noeljary/Inclinometer/board/INCLINOMETER_BOARD.png

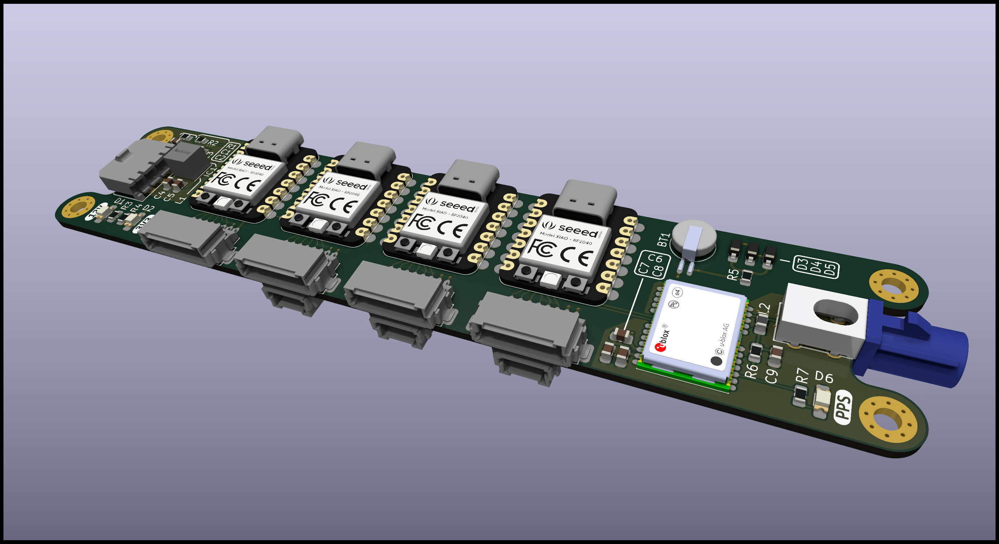
board/INCLINOMETER_BOARD.png
