noeljary/Inclinometer/board/test_bench/display_board.3mf

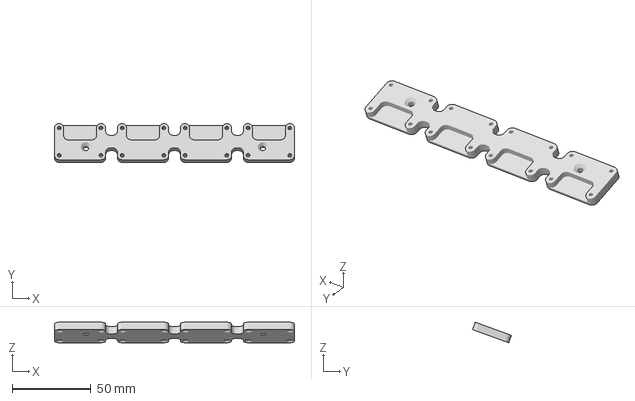
[picture p2: CAD file, 2023-11-25]
board/test_bench/display_board.3mf
152.5 x 24.7 x 13.1 mm
