noeljary/Inclinometer/board/test_bench/riser.3mf

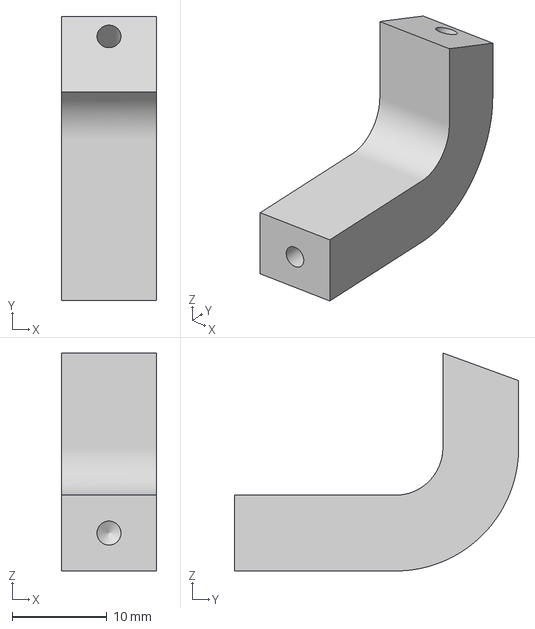
[picture p3: CAD file, 2023-11-25]
board/test_bench/riser.3mf
10.0 x 30.0 x 23.0 mm
