noeljary/Inclinometer/board/test_bench/base.3mf

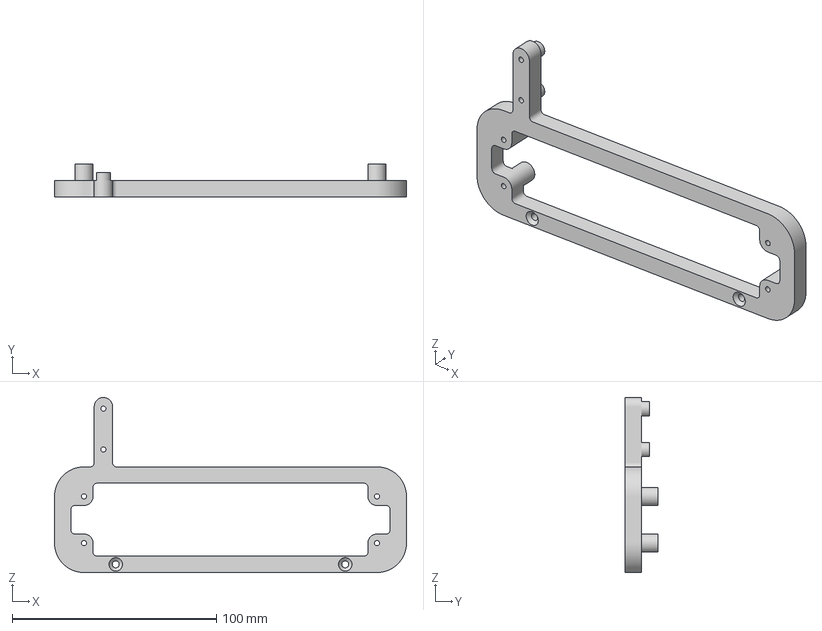
[picture p4: CAD file, 2023-11-25]
board/test_bench/base.3mf
172.4 x 16.0 x 85.8 mm
