noeljary/Inclinometer/board/INCLINOMETER_BOARD.kicad_pcb

## KiCad design board/INCLINOMETER_BOARD.kicad_pcb (2023-11-25)

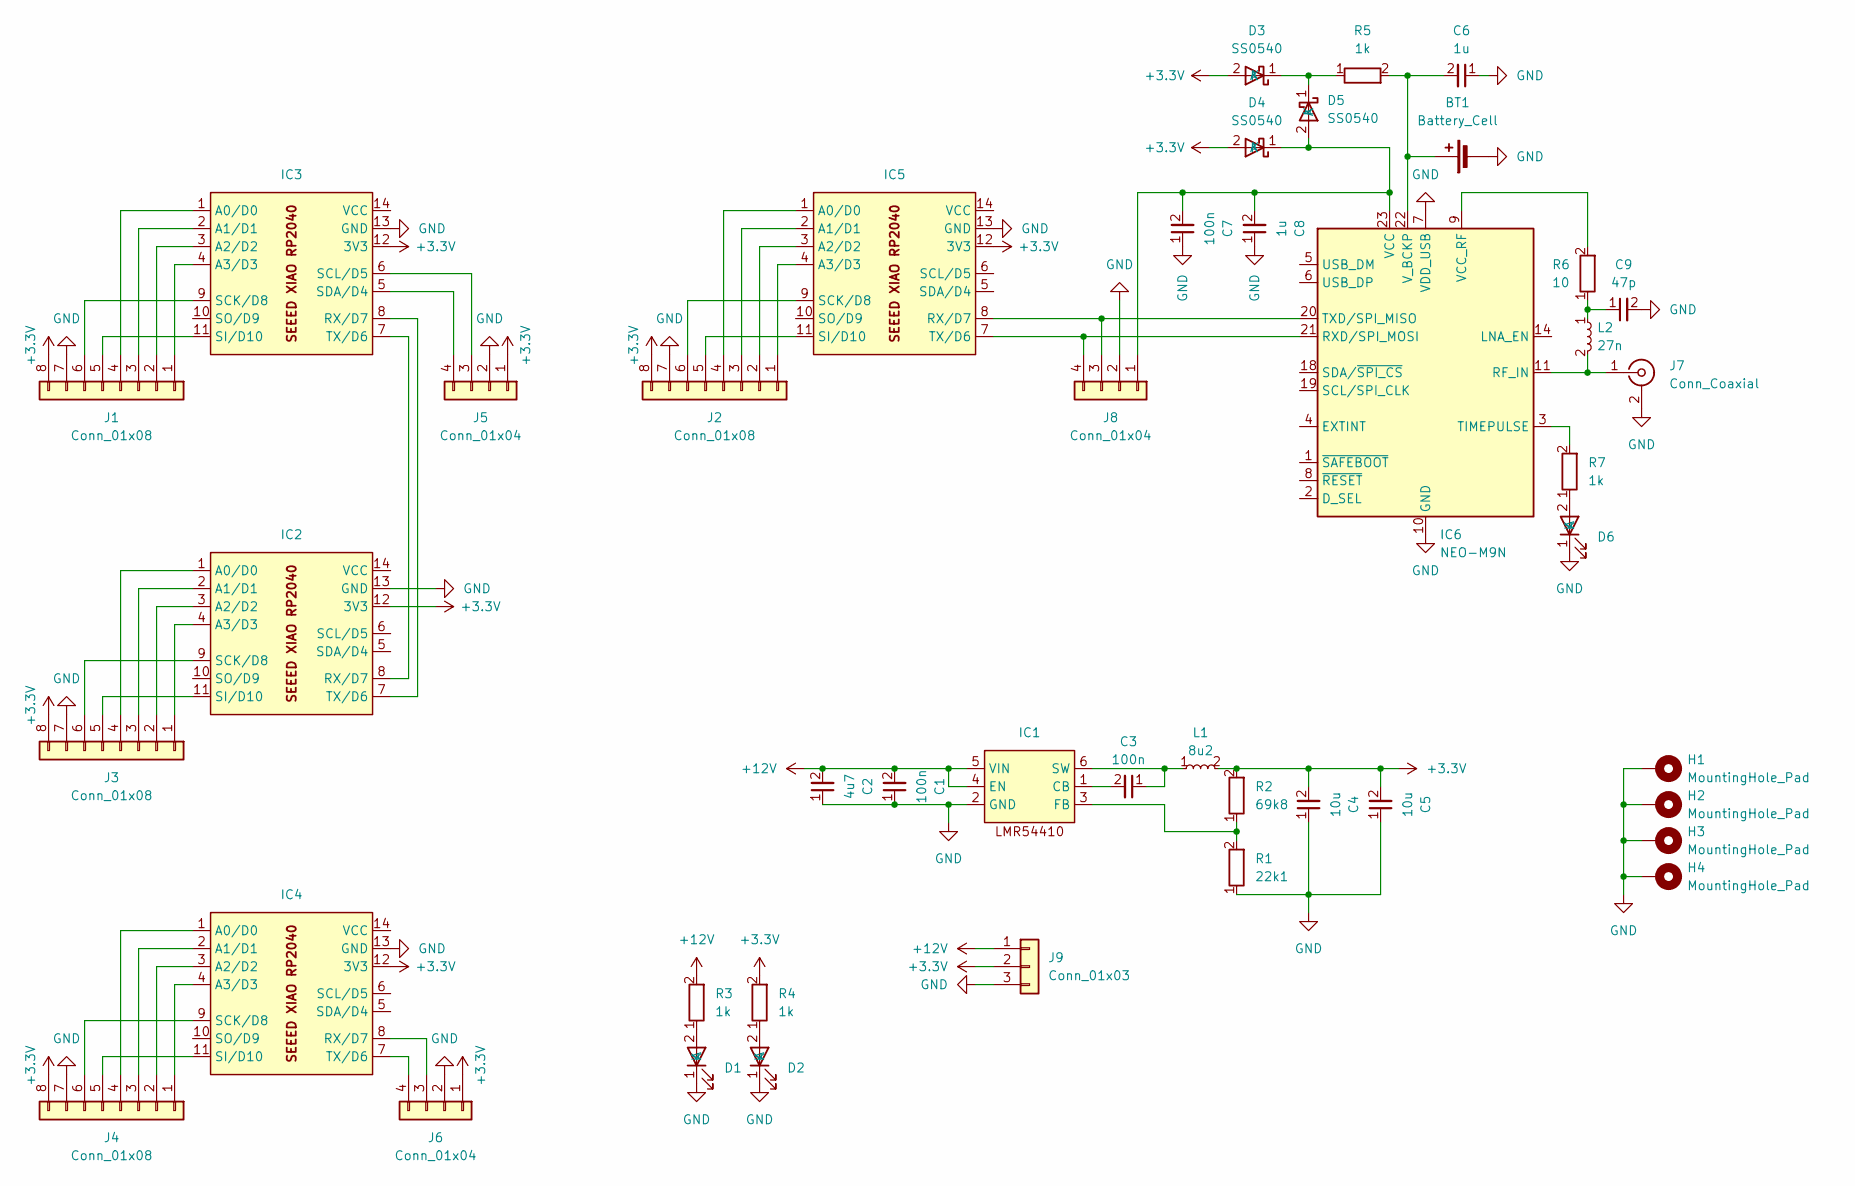
[picture p5: schematic INCLINOMETER_BOARD.kicad_sch]

Parts:
BT1: Battery_Cell; BAT-MS621
C1, C3, C7: 100n; C0805
C2: 4u7; C0805
C4, C5: 10u; C0805
C6, C8: 1u; C0805
C9: 47p; C0805
D1, D2, D6: 1206
D3, D4, D5: SS0540; SOD-123
H1, H2, H3, H4: MountingHole_Pad; MountingHole_3.2mm_M3_Pad_Via
IC1: SOT23-6
IC2, IC3, IC4, IC5: SEEED_XIAO
IC6: NEO-M9N; UBLOX-NEO-M9N
J1, J2, J3, J4: Conn_01x08; TE-292228-8
J5, J6, J8: Conn_01x04; TE-292228-4
J7: Conn_Coaxial; FAKRA_R197.160._28
J9: Conn_01x03; MICROFIT3.0-1x3-HORIZ
L1: 8u2; L6055
L2: 27n; L0805
R1: 22k1; R0805
R2: 69k8; R0805
R3, R4, R5, R7: 1k; R0805
R6: 10; R0805

Connections:
+3.3V: C4.2, C5.2, D3.2 (A), D4.2 (A), IC2.12 (3V3), IC3.12 (3V3), IC4.12 (3V3), IC5.12 (3V3), J1.8, J2.8, J3.8, J4.8, J5.1, J6.1, J9.2, L1.2, R2.2, R4.2
+12V: C1.2, C2.2, IC1.4 (EN), IC1.5 (VIN), J9.1, R3.2
GND: BT1.2 (-), C1.1, C2.1, C4.1, C5.1, C6.1, C7.1, C8.1, C9.2, D1.1 (K), D2.1 (K), D6.1 (K), H1.1, H2.1, H3.1, H4.1, IC1.2 (GND), IC2.13 (GND), IC3.13 (GND), IC4.13 (GND), IC5.13 (GND), IC6.7 (VDD_USB), IC6.10 (GND), IC6.12 (GND), IC6.13 (GND), IC6.24 (GND), J1.7, J2.7, J3.7, J4.7, J5.2, J6.2, J7.2 (Ext), J8.2, J9.3, R1.1
unnamed: BT1.1 (+), C6.2, IC6.22 (V_BCKP), R5.2
unnamed: C9.1, L2.1, R6.1
unnamed: D1.2 (A), R3.1
unnamed: D2.2 (A), R4.1
unnamed: D3.1 (K), D5.1 (K), R5.1
unnamed: C7.2, C8.2, D4.1 (K), D5.2 (A), IC6.23 (VCC), J8.1
unnamed: D6.2 (A), R7.1
unnamed: C3.2, IC1.1 (CB)
unnamed: IC1.3 (FB), R1.2, R2.1
unnamed: C3.1, IC1.6 (SW), L1.1
unnamed: IC2.1 (A0/D0), J3.4
unnamed: IC2.2 (A1/D1), J3.3
unnamed: IC2.3 (A2/D2), J3.2
unnamed: IC2.4 (A3/D3), J3.1
unnamed: IC2.8 (RX/D7), IC3.7 (TX/D6)
unnamed: IC2.9 (SCK/D8), J3.6
unnamed: IC2.11 (SI/D10), J3.5
unnamed: IC2.7 (TX/D6), IC3.8 (RX/D7)
unnamed: IC3.1 (A0/D0), J1.4
unnamed: IC3.2 (A1/D1), J1.3
unnamed: IC3.3 (A2/D2), J1.2
unnamed: IC3.4 (A3/D3), J1.1
unnamed: IC3.9 (SCK/D8), J1.6
unnamed: IC3.6 (SCL/D5), J5.3
unnamed: IC3.5 (SDA/D4), J5.4
unnamed: IC3.11 (SI/D10), J1.5
unnamed: IC4.1 (A0/D0), J4.4
unnamed: IC4.2 (A1/D1), J4.3
unnamed: IC4.3 (A2/D2), J4.2
unnamed: IC4.4 (A3/D3), J4.1
unnamed: IC4.8 (RX/D7), J6.3
unnamed: IC4.9 (SCK/D8), J4.6
unnamed: IC4.11 (SI/D10), J4.5
unnamed: IC4.7 (TX/D6), J6.4
unnamed: IC5.1 (A0/D0), J2.4
unnamed: IC5.2 (A1/D1), J2.3
unnamed: IC5.3 (A2/D2), J2.2
unnamed: IC5.4 (A3/D3), J2.1
unnamed: IC5.8 (RX/D7), IC6.20 (TXD/SPI_MISO), J8.3
unnamed: IC5.9 (SCK/D8), J2.6
unnamed: IC5.11 (SI/D10), J2.5
unnamed: IC5.7 (TX/D6), IC6.21 (RXD/SPI_MOSI), J8.4
unnamed: IC6.11 (RF_IN), J7.1 (In), L2.2
unnamed: IC6.3 (TIMEPULSE), R7.2
unnamed: IC6.9 (VCC_RF), R6.2

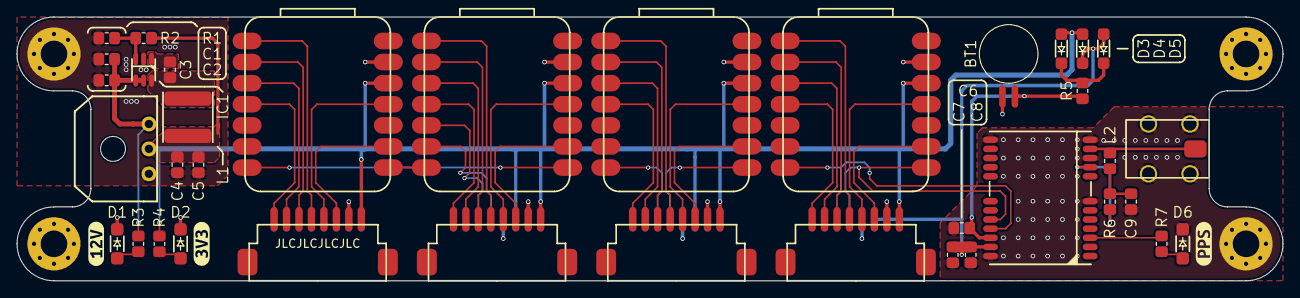
[picture p6: board INCLINOMETER_BOARD.kicad_pcb from above]

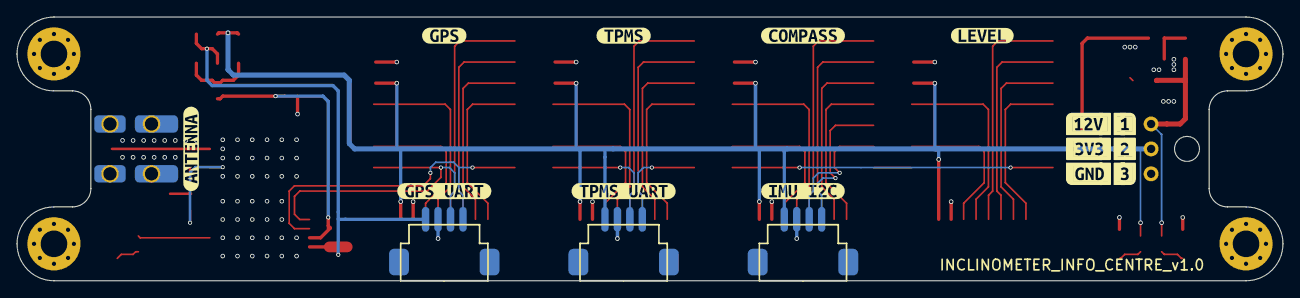
[picture p7: board INCLINOMETER_BOARD.kicad_pcb from below]

Board: 4 copper layers, 152.4 x 31.8 mm, 61 parts (17 on the bottom side), 48 nets.

Other parts of the board:
kibuzzard-64DFFC28: G***; kibuzzard-64DFFC28
kibuzzard-64EF6B93: G***; kibuzzard-64EF6B93
kibuzzard-64EF6BB1: G***; kibuzzard-64EF6BB1
kibuzzard-64EF6BC1: G***; kibuzzard-64EF6BC1
kibuzzard-64EF9CA5: G***; kibuzzard-64EF9CA5
kibuzzard-64EF9CAD: G***; kibuzzard-64EF9CAD
kibuzzard-64EF9D40: G***; kibuzzard-64EF9D40
kibuzzard-64EF9D48: G***; kibuzzard-64EF9D48
kibuzzard-64EF9D56: G***; kibuzzard-64EF9D56
kibuzzard-64EFA0F6: G***; kibuzzard-64EFA0F6
kibuzzard-64EFA8FB: G***; kibuzzard-64EFA8FB
kibuzzard-64F4D53D: G***; kibuzzard-64F4D53D
kibuzzard-64F4D513: G***; kibuzzard-64F4D513
kibuzzard-64F4D629: G***; kibuzzard-64F4D629
kibuzzard-650ECDA2: G***; kibuzzard-650ECDA2
kibuzzard-650ECDAE: G***; kibuzzard-650ECDAE
kibuzzard-65062FEF: G***; kibuzzard-65062FEF
