noeljary/Inclinometer/(commit log)

2021-07-15 Initial commit of basic compass/pitch/roll to serial output
2022-12-03 Add circuit schematics and board
    [board.brd, board.sch]
2022-12-23 Sort bug where lat/lng show negative despite having relevant cardinal
    [code.py]
2022-12-23 Fix introduced tab whitespace
    [code.py]
2023-11-25 Migrated board design into KiCAD7 from EAGLE. v1.0 of manufactured board including gerber files
    [INCLINOMETER_BOARD-B_Cu.gbl, INCLINOMETER_BOARD-B_Mask.gbs, INCLINOMETER_BOARD-B_Paste.gbp, INCLINOMETER_BOARD-B_Silkscreen.gbo, INCLINOMETER_BOARD-Edge_Cuts.gm1, INCLINOMETER_BOARD-F_Cu.gtl, INCLINOMETER_BOARD-F_Mask.gts, INCLINOMETER_BOARD-F_Paste.gtp]
2023-11-25 Mock tool for TPMS system - sends data to TPMS Display as if it had received it wirelessly for testing purposes
2023-11-25 Attaching micropython binary compiled for RP2040, including C driver for GC9A01 and updated framebuffer with bitmap image and font support
2023-11-25 Adding initial revision of GPS module code in micropython. Needs refactoring to same framework level as TPMS Display
2023-11-25 First revision of TPMS Wirelss Receiver code. Refactored version of JSMSolns 'Arduino TPMS Tyre Pressure Display' - removed all display logic, and unnecessary parts, initially only supports Toyota PM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
2023-11-25 Refactored to TPMS Display Standard. Series of GPS Parsing Library bug fixes.
    [gps.py, main.py]
2023-11-26 Fix what seems to be a find/replace issue in TPMS code but no idea how it got there
    [main.py]
